slapab/dpf_pressure_hardware/dpf_ressure_dumper.kicad_pcb

## KiCad design dpf_ressure_dumper.kicad_pcb (2020-04-13)

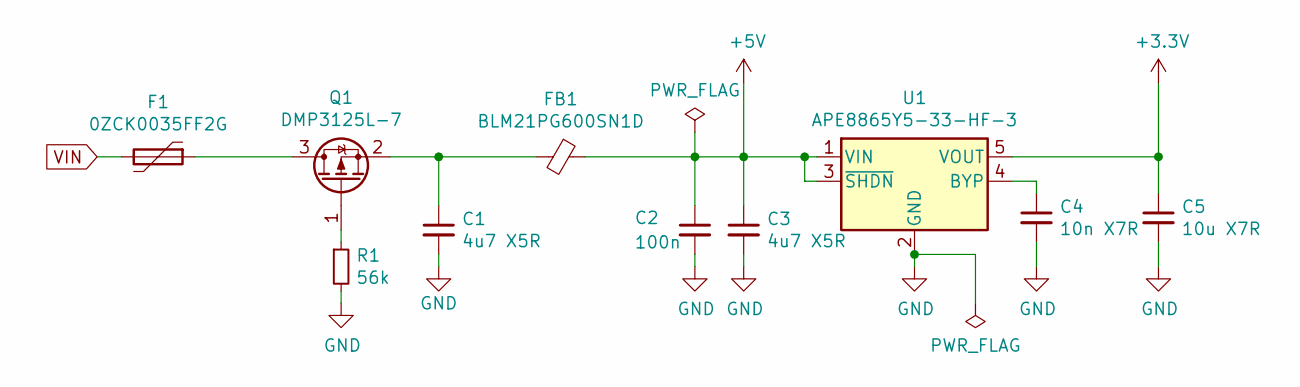
[picture p1: schematic PowerSupply.sch]

Parts:
C1, C3: 4u7 X5R; C_0603_1608Metric_Pad1.05x0.95mm_HandSolder
C2: 100n; C_0603_1608Metric
C4: 10n X7R; C_0805_2012Metric
C5: 10u X7R; C_1206_3216Metric
F1: 0ZCK0035FF2G; Fuse_0805_2012Metric_Pad1.15x1.40mm_HandSolder
FB1: BLM21PG600SN1D; L_0805_2012Metric
Q1: DMP3125L-7; SOT-23
R1: 56k; R_0805_2012Metric
U1: APE8865Y5-33-HF-3; SOT-23-5

Connections:
+3V3: C5.1, U1.5 (VOUT); also elsewhere on the board
+5V: C2.1, C3.1, FB1.1, U1.1 (VIN), U1.3 (~SHDN~); also elsewhere on the board
GND: C1.2, C2.2, C3.2, C4.2, C5.2, R1.2, U1.2 (GND); also elsewhere on the board
unnamed: C1.1, FB1.2, Q1.2 (S)
unnamed: C4.1, U1.4 (BYP)
unnamed: F1.1, Q1.3 (D)
unnamed: Q1.1 (G), R1.1
VIN: F1.2; also elsewhere on the board

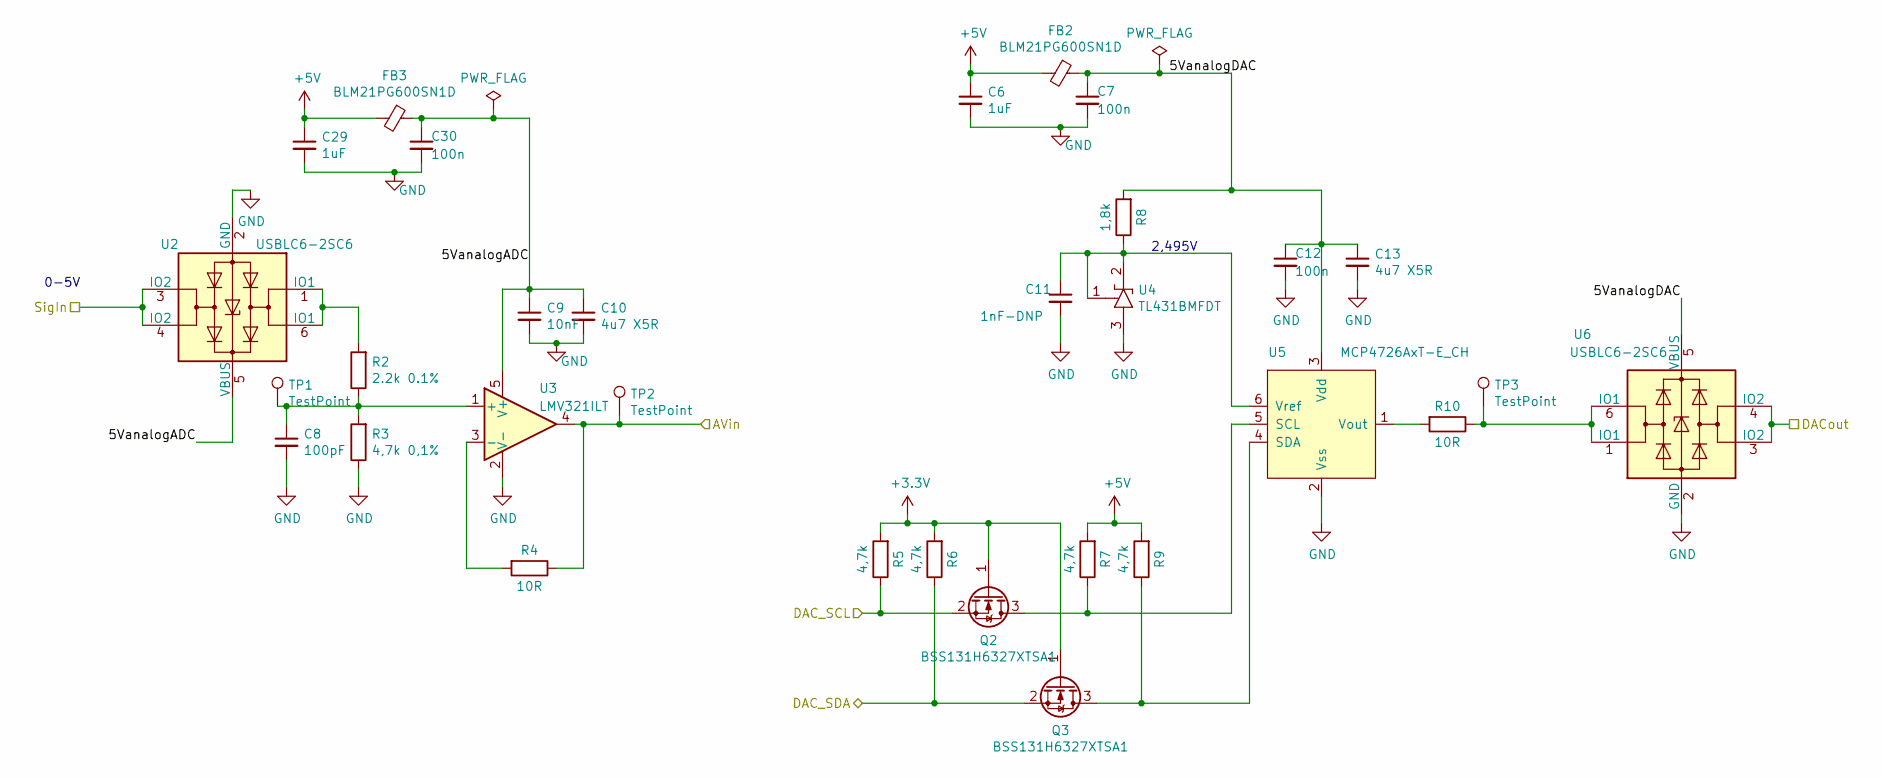
[picture p2: schematic Analog.sch]

Parts:
C6, C29: 1uF; C_0603_1608Metric
C7, C12, C30: 100n; C_0603_1608Metric
C8: 100pF; C_0805_2012Metric
C9: 10nF; C_0805_2012Metric
C10, C13: 4u7 X5R; C_0603_1608Metric_Pad1.05x0.95mm_HandSolder
C11: 1nF-DNP; C_0402_1005Metric
FB2, FB3: BLM21PG600SN1D; L_0805_2012Metric
Q2, Q3: BSS131H6327XTSA1; SOT-23
R2: 2.2k 0.1%; R_0603_1608Metric
R3: 4,7k 0,1%; R_0603_1608Metric
R4, R10: 10R; R_0603_1608Metric
R5, R6, R7, R9: 4,7k; R_0805_2012Metric
R8: 1,8k; R_0805_2012Metric
TP1, TP2, TP3: TestPoint; TestPoint_Loop_D1.80mm_Drill1.0mm_Beaded
U2, U6: USBLC6-2SC6; SOT-23-6
U3: LMV321ILT; SOT-23-5
U4: TL431BMFDT; SOT-23
U5: MCP4726AxT-E_CH; SOT-23-6

Connections:
+3V3: Q2.1 (G), Q3.1 (G), R5.2, R6.2; also elsewhere on the board
+5V: C6.1, C29.1, FB2.2, FB3.2, R7.2, R9.2; also elsewhere on the board
/AnalogSections/5VanalogADC: C9.1, C10.1, C30.1, FB3.1, U2.5 (VBUS), U3.5 (V+)
/AnalogSections/5VanalogDAC: C7.1, C12.1, C13.1, FB2.1, R8.2, U5.3 (Vdd), U6.5 (VBUS)
/AnalogSections/AVin: R4.1, TP2.1, U3.4; also elsewhere on the board
/AnalogSections/DAC_SCL: Q2.2 (S), R5.1; also elsewhere on the board
/AnalogSections/DAC_SDA: Q3.2 (S), R6.1; also elsewhere on the board
/Connectors/DAC_OUT: U6.3 (IO2), U6.4 (IO2); also elsewhere on the board
/Connectors/SIG_IN: U2.3 (IO2), U2.4 (IO2); also elsewhere on the board
GND: C6.2, C7.2, C8.2, C9.2, C10.2, C11.2, C12.2, C13.2, C29.2, C30.2, R3.1, U2.2 (GND), U3.2 (V-), U4.3, U5.2 (Vss), U6.2 (GND); also elsewhere on the board
unnamed: C8.1, R2.1, R3.2, TP1.1, U3.1 (+)
unnamed: C11.1, R8.1, U4.1, U4.2, U5.6 (Vref)
unnamed: Q2.3 (D), R7.1, U5.5 (SCL)
unnamed: Q3.3 (D), R9.1, U5.4 (SDA)
unnamed: R2.2, U2.1 (IO1), U2.6 (IO1)
unnamed: R4.2, U3.3 (-)
unnamed: R10.1, TP3.1, U6.1 (IO1), U6.6 (IO1)
unnamed: R10.2, U5.1 (Vout)

Notes on the sheet:
0-5V
2,495V

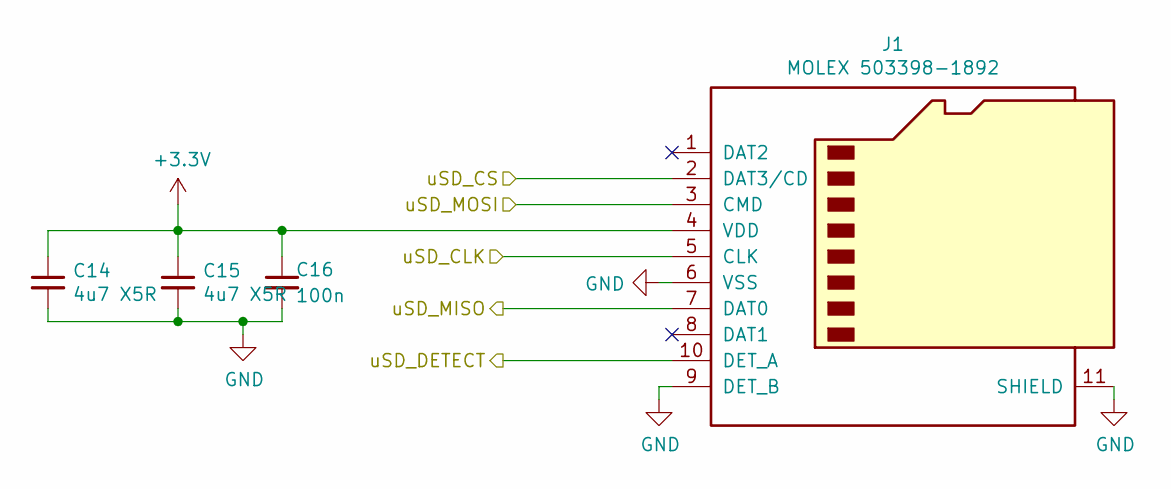
[picture p3: schematic uSD.sch]

Parts:
C14, C15: 4u7 X5R; C_0603_1608Metric_Pad1.05x0.95mm_HandSolder
C16: 100n; C_0603_1608Metric
J1: MOLEX 503398-1892; uSD_MOLEX_503398_1892

Connections:
+3V3: C14.1, C15.1, C16.1, J1.4 (VDD); also elsewhere on the board
/nRF51822/uSD_CLK: J1.5 (CLK); also elsewhere on the board
/nRF51822/uSD_CS: J1.2 (DAT3/CD); also elsewhere on the board
/nRF51822/uSD_DETECT: J1.10 (DET_A); also elsewhere on the board
/nRF51822/uSD_MISO: J1.7 (DAT0); also elsewhere on the board
/nRF51822/uSD_MOSI: J1.3 (CMD); also elsewhere on the board
GND: C14.2, C15.2, C16.2, J1.6 (VSS), J1.9 (DET_B), J1.11 (SHIELD); also elsewhere on the board

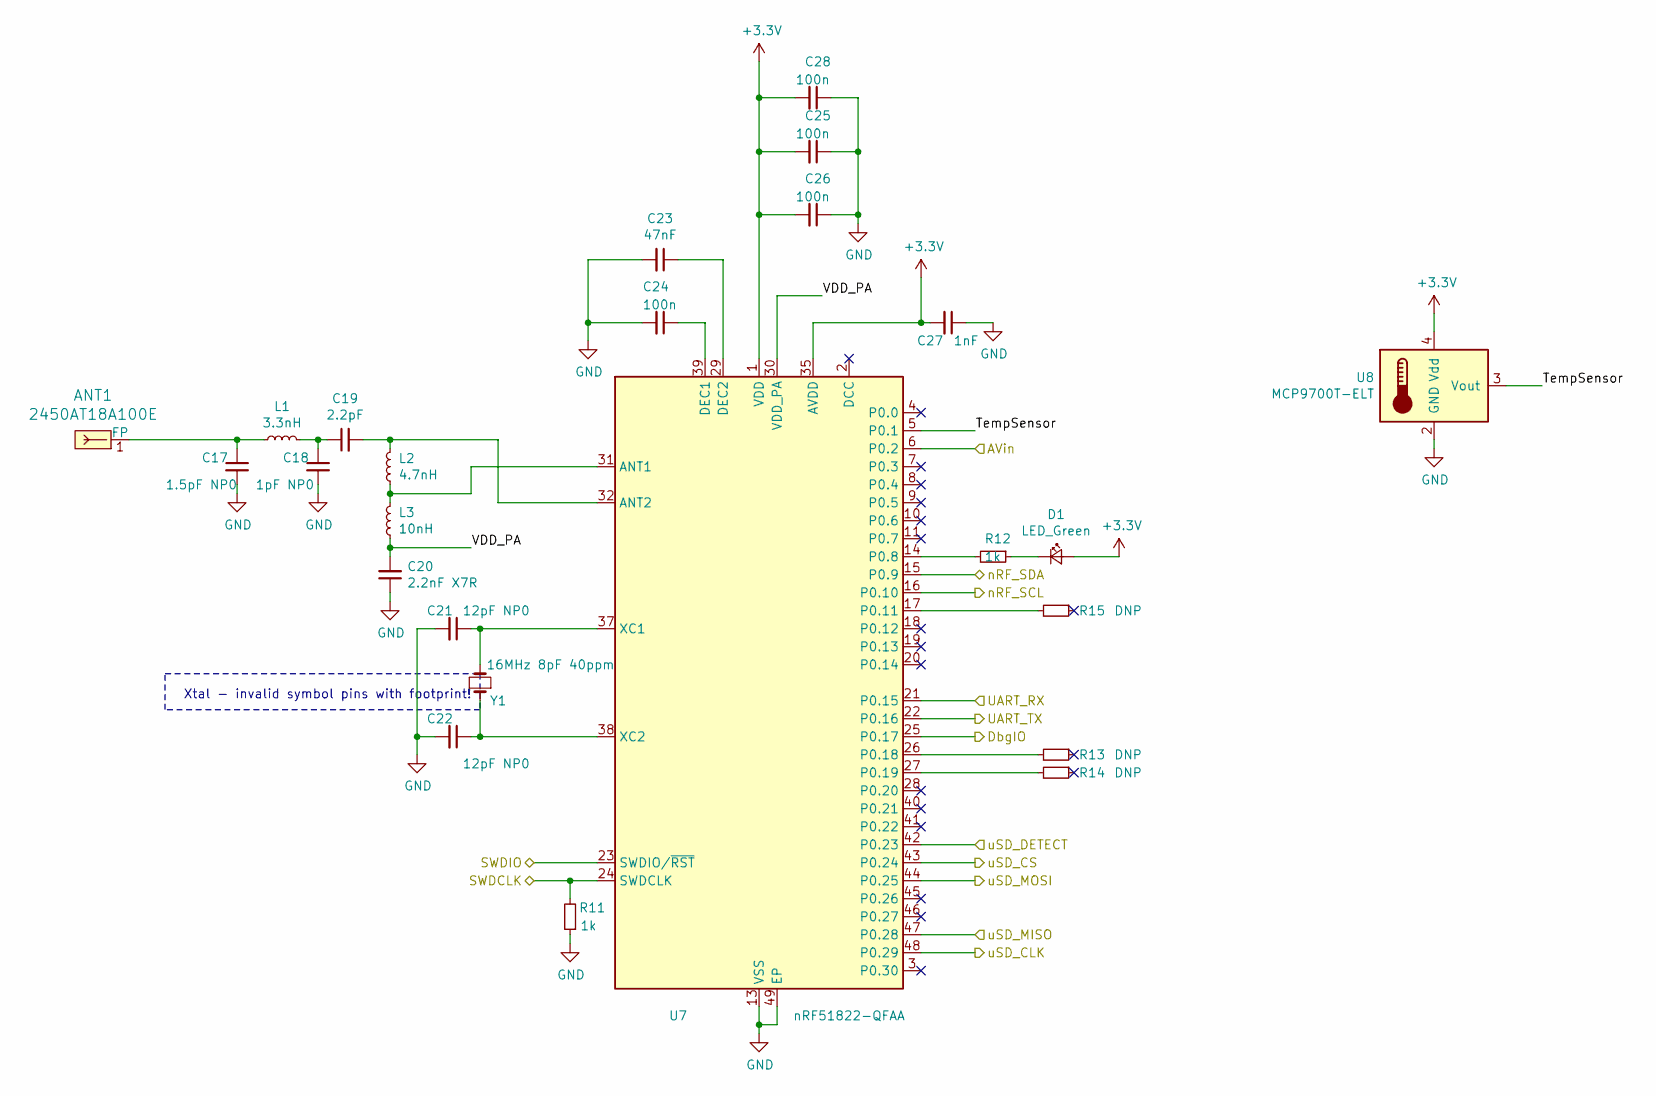
[picture p4: schematic nRF.sch]

Parts:
ANT1: 2450AT18A100E; 2.4GHz_ISM_antenna_RFANT8010080A3T; MPN RFANT8010080A3T
C17: 1.5pF NP0; C_0603_1608Metric
C18: 1pF NP0; C_0603_1608Metric
C19: 2.2pF; C_0402_1005Metric
C20: 2.2nF X7R; C_0402_1005Metric
C21, C22: 12pF NP0; C_0402_1005Metric
C23: 47nF; C_0402_1005Metric
C24, C25, C26, C28: 100n; C_0603_1608Metric
C27: 1nF; C_0603_1608Metric
D1: LED_Green; LED_1206_3216Metric
L1: 3.3nH; L_0402_1005Metric
L2: 4.7nH; L_0402_1005Metric
L3: 10nH; L_0402_1005Metric
R11, R12: 1k; R_0603_1608Metric
R13, R14, R15: DNP; R_0603_1608Metric
U7: nRF51822-QFAA; QFN-48-1EP_6x6mm_P0.4mm_EP4.6x4.6mm
U8: MCP9700T-ELT; SOT-353_SC-70-5
Y1: 16MHz 8pF 40ppm; Crystal_SMD_Abracon_ABM10-4Pin_2.5x2.0mm

Connections:
+3V3: C25.2, C26.2, C27.2, C28.2, D1.2 (A), U7.1 (VDD), U7.12 (VDD), U7.35 (AVDD), U7.36 (AVDD), U8.4 (Vdd); also elsewhere on the board
/AnalogSections/AVin: U7.6 (P0.2); also elsewhere on the board
/AnalogSections/DAC_SCL: U7.16 (P0.10); also elsewhere on the board
/AnalogSections/DAC_SDA: U7.15 (P0.9); also elsewhere on the board
/Connectors/SWDCLK: R11.2, U7.24 (SWDCLK); also elsewhere on the board
/Connectors/SWDIO: U7.23 (SWDIO/~RST); also elsewhere on the board
/Connectors/UART_RX: U7.21 (P0.15); also elsewhere on the board
/Connectors/UART_TX: U7.22 (P0.16); also elsewhere on the board
/nRF51822/DbgIO: U7.25 (P0.17); also elsewhere on the board
/nRF51822/TempSensor: U7.5 (P0.1), U8.3 (Vout)
/nRF51822/VDD_PA: C20.2, L3.1, U7.30 (VDD_PA)
/nRF51822/uSD_CLK: U7.48 (P0.29); also elsewhere on the board
/nRF51822/uSD_CS: U7.43 (P0.24); also elsewhere on the board
/nRF51822/uSD_DETECT: U7.42 (P0.23); also elsewhere on the board
/nRF51822/uSD_MISO: U7.47 (P0.28); also elsewhere on the board
/nRF51822/uSD_MOSI: U7.44 (P0.25); also elsewhere on the board
GND: C17.2, C18.2, C20.1, C21.2, C22.2, C23.2, C24.2, C25.1, C26.1, C27.1, C28.1, R11.1, U7.13 (VSS), U7.33 (VSS), U7.34 (VSS), U7.49 (EP), U8.2 (GND); also elsewhere on the board
unnamed: ANT1.1 (FP), C17.1, L1.1
unnamed: C18.1, C19.1, L1.2
unnamed: C19.2, L2.2, U7.32 (ANT2)
unnamed: C21.1, U7.37 (XC1), Y1.2
unnamed: C22.1, U7.38 (XC2), Y1.1
unnamed: C23.1, U7.29 (DEC2)
unnamed: C24.1, U7.39 (DEC1)
unnamed: D1.1 (K), R12.1
unnamed: L2.1, L3.2, U7.31 (ANT1)
unnamed: R12.2, U7.14 (P0.8)
unnamed: R13.2, U7.26 (P0.18)
unnamed: R14.2, U7.27 (P0.19)
unnamed: R15.2, U7.17 (P0.11)

Notes on the sheet:
Xtal - invalid symbol pins with footprint!

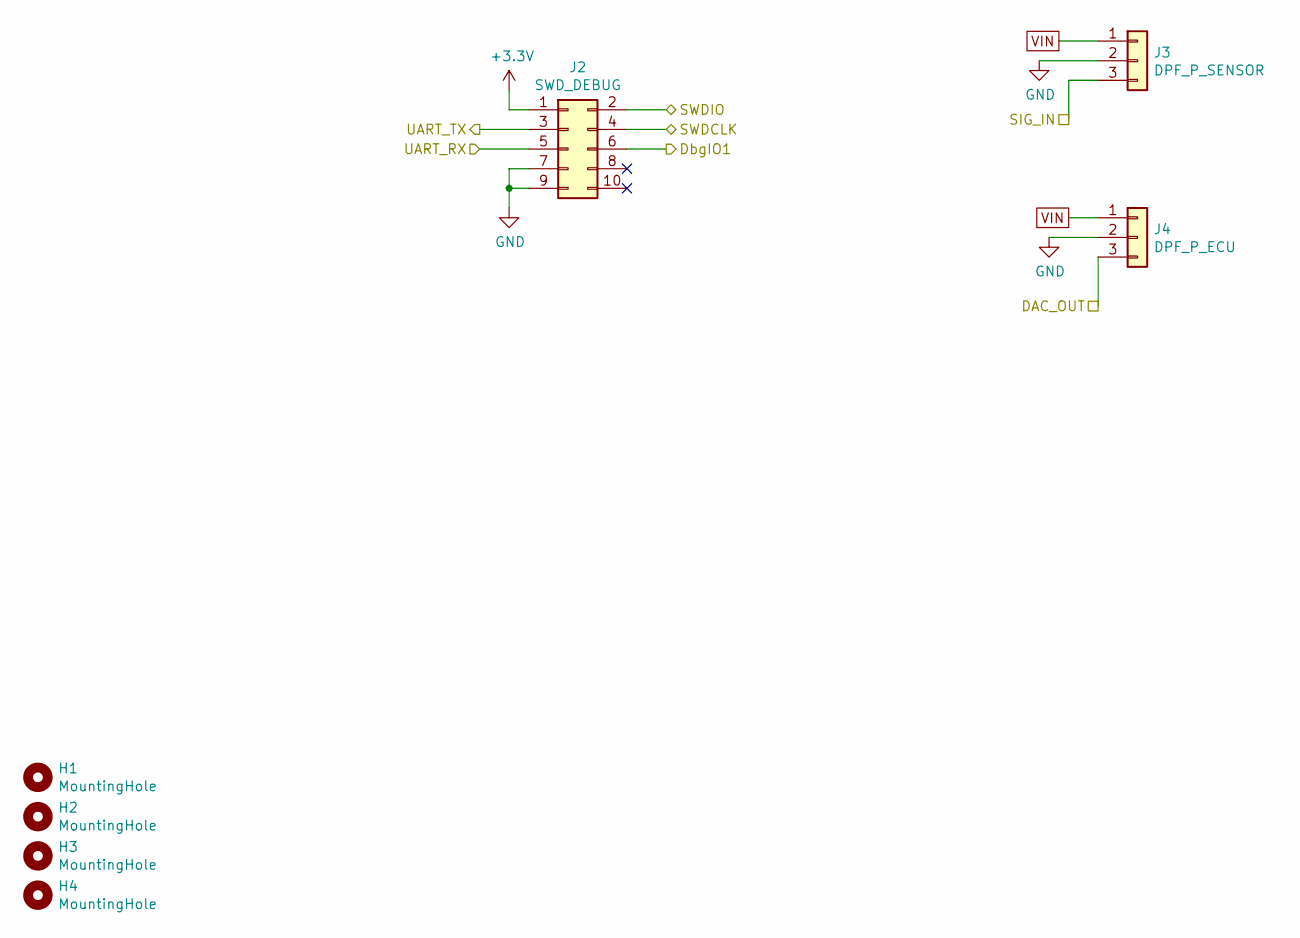
[picture p5: schematic Connectors.sch]

Parts:
H1, H2, H3, H4: MountingHole; MountingHole_2.5mm
J2: SWD_DEBUG; PinHeader_2x05_P1.27mm_Vertical_SMD
J3: DPF_P_SENSOR; JST_EH_B3B-EH-A_1x03_P2.50mm_Vertical
J4: DPF_P_ECU; JST_EH_B3B-EH-A_1x03_P2.50mm_Vertical

Connections:
+3V3: J2.1; also elsewhere on the board
/Connectors/DAC_OUT: J4.3; also elsewhere on the board
/Connectors/SIG_IN: J3.3; also elsewhere on the board
/Connectors/SWDCLK: J2.4; also elsewhere on the board
/Connectors/SWDIO: J2.2; also elsewhere on the board
/Connectors/UART_RX: J2.5; also elsewhere on the board
/Connectors/UART_TX: J2.3; also elsewhere on the board
/nRF51822/DbgIO: J2.6; also elsewhere on the board
GND: J2.7, J2.9, J3.2, J4.2; also elsewhere on the board
VIN: J3.1, J4.1; also elsewhere on the board

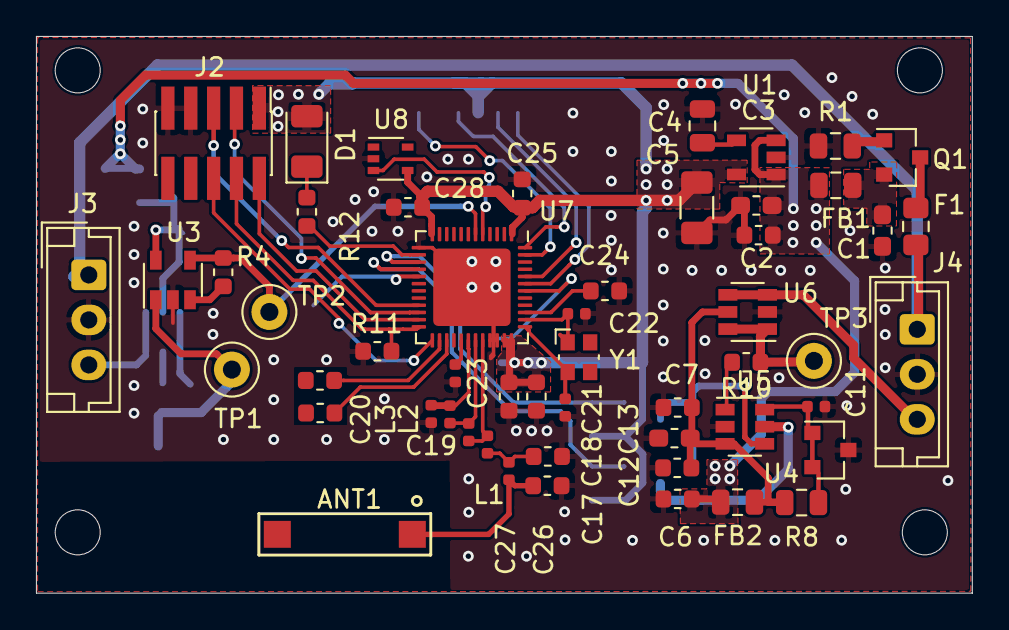
[picture p6: board dpf_ressure_dumper.kicad_pcb from above]

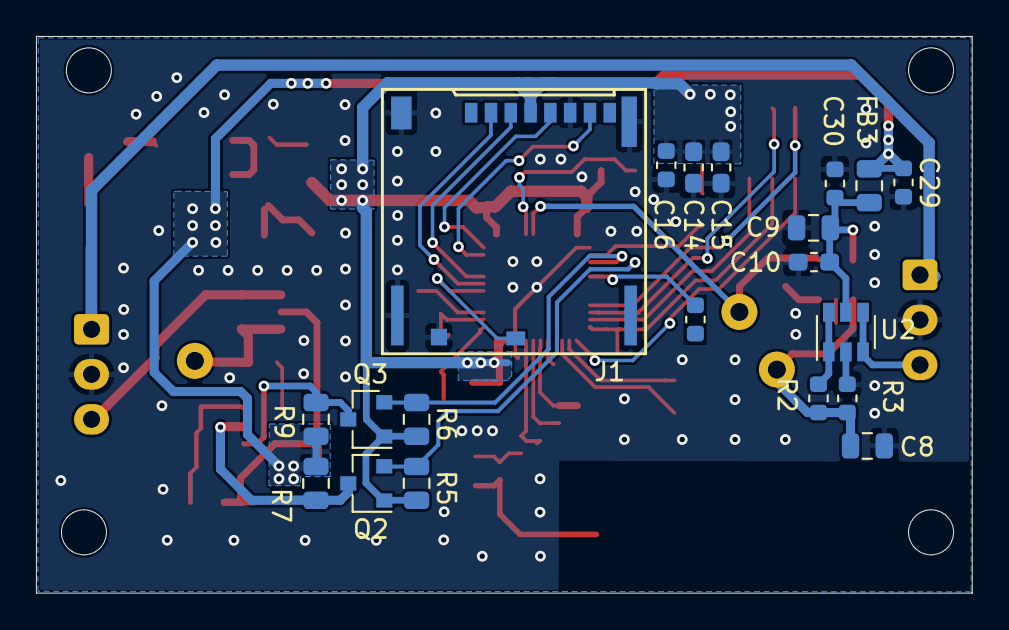
[picture p7: board dpf_ressure_dumper.kicad_pcb from below]

Board: 2 copper layers, 52.0 x 30.9 mm, 77 parts (20 on the bottom side), 48 nets.
